aidancurtis/finger_ecg_board/hardware/ecg_board/ecg_board.pdf

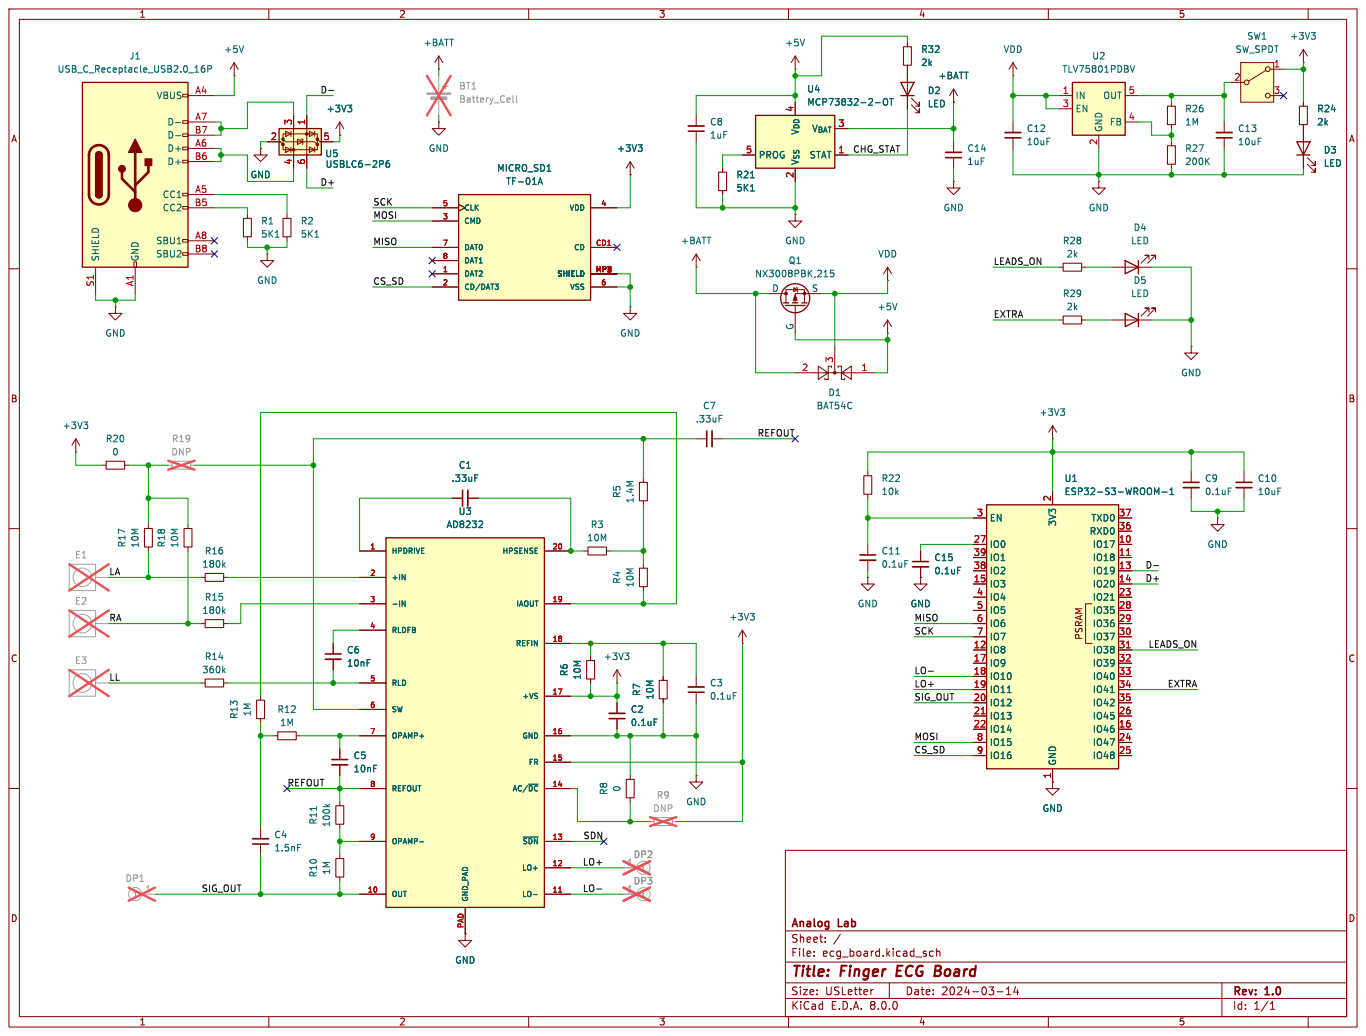
[picture p1: page 1]

2 EN 3 FB 4 OUT 5 U2 TLV75801PDBV R19 DNP

Id: 1/1 Title: Finger ECG Board
