aidancurtis/finger_ecg_board/hardware/ecg_board/ecg_board.kicad_pcb

## KiCad design hardware/ecg_board/ecg_board.kicad_pcb (2024-04-04)

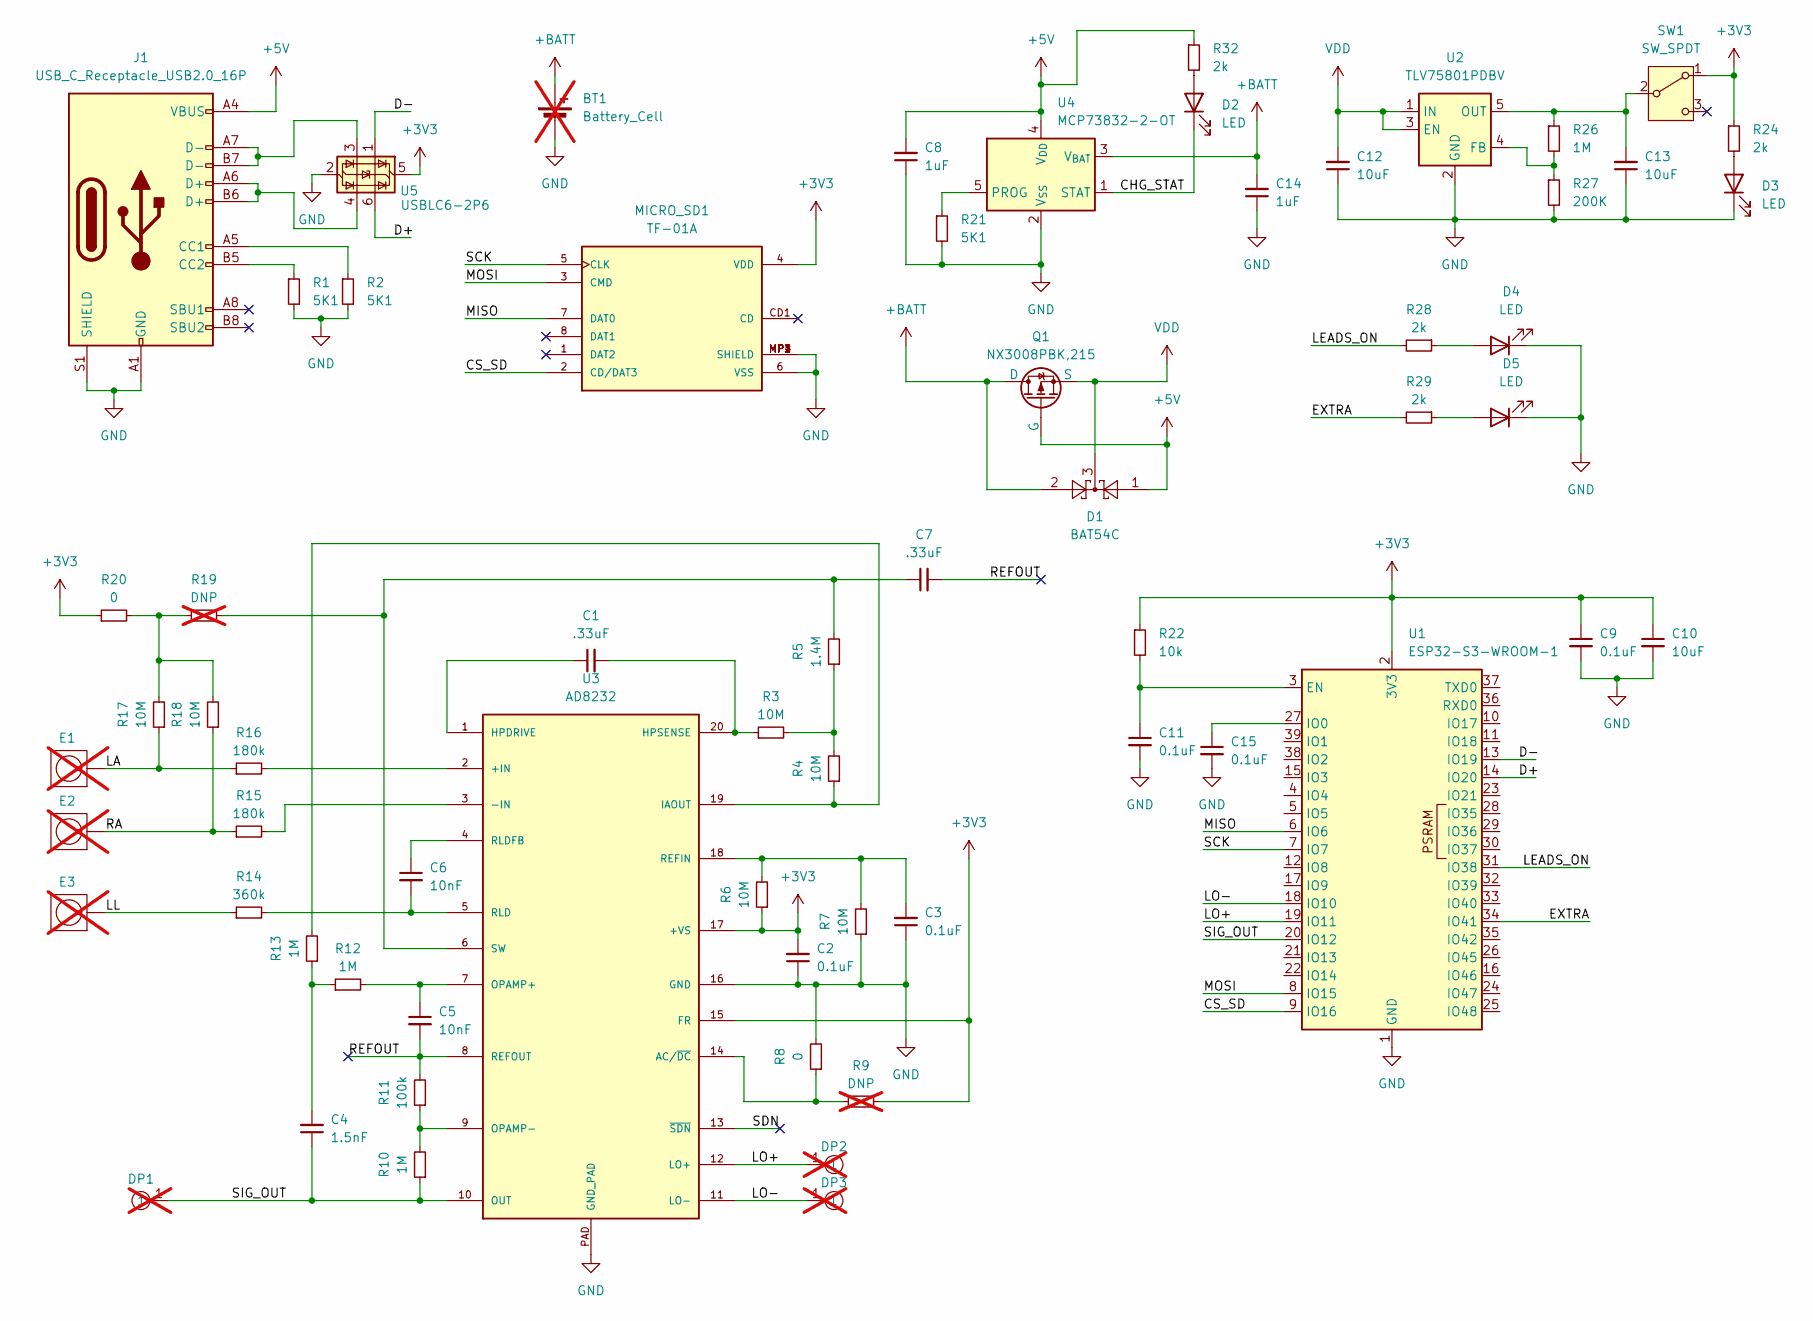
[picture p2: schematic ecg_board.kicad_sch, Finger ECG Board]

Parts:
BT1: Battery_Cell; battery_pads; not fitted
C1, C7: .33uF; C_0603_1608Metric; LCSC Part # C2991452
C2, C3, C9, C11, C15: 0.1uF; C_0603_1608Metric; LCSC Part # C14663
C4: 1.5nF; C_0603_1608Metric; LCSC Part # C1588
C5, C6: 10nF; C_0603_1608Metric; LCSC Part # C57112
C8, C14: 1uF; C_0603_1608Metric; LCSC Part # C15849
C10, C12, C13: 10uF; C_0805_2012Metric; LCSC Part # C19702
D1: BAT54C; SOT-23; LCSC Part # C2828464
D2, D3, D4: LED; LED_0603_1608Metric; LCSC Part # C2286
D5: LED; LED_0603_1608Metric; LCSC Part # C5123548
DP1, DP2, DP3: DebugPad; not fitted
E1, E2, E3: Finger_Electrode; not fitted
J1: USB_C_Receptacle_USB2.0_16P; USB_C_Receptacle_HCTL_HC-TYPE-C-16P-01A; LCSC Part # C2927038
MICRO_SD1: TF-01A; LCSC Part # C2889258
Q1: NX3008PBK,215; SOT-23-3; LCSC Part # C131670
R1, R2, R21: 5K1; R_0603_1608Metric; LCSC Part # C23186
R3, R4, R6, R7, R17, R18: 10M; R_0603_1608Metric; LCSC Part # C7250
R5: 1.4M; R_0603_1608Metric; LCSC Part # C3016282
R8, R20: 0; R_0603_1608Metric; LCSC Part # C21189
R9, R19: DNP; R_0603_1608Metric; not fitted
R10, R12, R13, R26: 1M; R_0603_1608Metric; LCSC Part # C22935
R11: 100k; R_0603_1608Metric; LCSC Part # C25803
R14: 360k; R_0603_1608Metric; LCSC Part # C3016408
R15, R16: 180k; R_0603_1608Metric; LCSC Part # C325602
R22: 10k; R_0603_1608Metric; LCSC Part # C25804
R24, R28, R29, R32: 2k; R_0603_1608Metric; LCSC Part # C22975
R27: 200K; R_0603_1608Metric; LCSC Part # C25811
SW1: SW_SPDT; SW_SPDT_PCM12; LCSC Part # C109335
U1: ESP32-S3-WROOM-1; LCSC Part # C2913197
U2: TLV75801PDBV; SOT-23-5; LCSC Part # C2877852
U3: AD8232; LFCSP_20; LCSC Part # C43216
U4: MCP73832-2-OT; SOT-23-5; LCSC Part # C38066
U5: USBLC6-2P6; SOT-666; LCSC Part # C2827693

Connections:
+3V3: C2.2, C9.1, C10.1, MICRO_SD1.4 (VDD), R6.1, R9.2, R20.1, R22.1, R24.1, SW1.1 (A), U1.2 (3V3), U3.15 (FR), U3.17 (+VS), U5.5 (VBUS)
+5V: C8.2, D1.1, J1.A4 (VBUS), J1.A9 (VBUS), J1.B4 (VBUS), J1.B9 (VBUS), Q1.2 (G), R32.1, U4.4 (V_{DD})
+BATT: BT1.1 (+), C14.2, D1.2, Q1.1 (D), U4.3 (V_{BAT})
/CHG_STAT: D2.1 (K), U4.1 (STAT)
/CS_SD: MICRO_SD1.2 (CD/DAT3), U1.9 (IO16)
/D+: U1.14 (IO20), U5.6 (I/O1)
/D-: U1.13 (IO19), U5.1 (I/O1)
/EXTRA: R29.2, U1.34 (IO41)
/LA: E1.1, R16.1, R17.1
/LEADS_ON: R28.2, U1.31 (IO38)
/LL: E3.1, R14.1
/LO+: DP2.1, U1.19 (IO11), U3.12 (LO+); also elsewhere on the board
/LO-: DP3.1, U1.18 (IO10), U3.11 (LO-); also elsewhere on the board
/MISO: MICRO_SD1.7 (DAT0), U1.6 (IO6)
/MOSI: MICRO_SD1.3 (CMD), U1.8 (IO15)
/RA: E2.1, R15.1, R18.1
/REFOUT: C5.2, C7.2, R11.2, U3.8 (REFOUT)
/SCK: MICRO_SD1.5 (CLK), U1.7 (IO7)
/SDN: U3.13 (~SDN)
/SIG_OUT: C4.1, DP1.1, R10.1, U1.20 (IO12), U3.10 (OUT); also elsewhere on the board
GND: BT1.2 (-), C2.1, C3.1, C8.1, C9.2, C10.2, C11.2, C12.1, C13.1, C14.1, C15.2, D3.1 (K), D4.1 (K), D5.1 (K), J1.A1 (GND), J1.A12 (GND), J1.B1 (GND), J1.B12 (GND), J1.S1 (SHIELD), MICRO_SD1.6 (VSS), MICRO_SD1.MP1 (SHIELD), MICRO_SD1.MP2 (SHIELD), MICRO_SD1.MP3 (SHIELD), MICRO_SD1.MP4 (SHIELD), R1.2, R2.2, R7.1, R8.2, R21.2, R27.2, U1.1 (GND), U1.40 (GND), U1.41 (GND), U2.2 (GND), U3.16 (GND), U3.PAD (GND_PAD), U4.2 (V_{SS}), U5.2 (GND)
unnamed: C4.2, R12.1, R13.1
unnamed: D2.2 (A), R32.2
unnamed: D3.2 (A), R24.2
unnamed: D4.2 (A), R28.1
unnamed: D5.2 (A), R29.1
unnamed: J1.A5 (CC1), R2.1
unnamed: J1.B5 (CC2), R1.1
unnamed: J1.A6 (D+), J1.B6 (D+), U5.4 (I/O2)
unnamed: J1.A7 (D-), J1.B7 (D-), U5.3 (I/O2)
unnamed: R3.2, R4.2, R5.1
unnamed: R17.2, R18.2, R19.1, R20.2
unnamed: C13.2, R26.1, SW1.2 (B), U2.5 (OUT)
unnamed: C11.1, R22.2, U1.3 (EN)
unnamed: C15.1, U1.27 (IO0)
unnamed: R26.2, R27.1, U2.4 (FB)
unnamed: R16.2, U3.2 (+IN)
unnamed: R15.2, U3.3 (-IN)
unnamed: R8.1, R9.1, U3.14 (AC/~DC)
unnamed 39: C1.1, U3.1 (HPDRIVE); also elsewhere on the board
unnamed 40: C1.2, R3.1, U3.20 (HPSENSE); also elsewhere on the board
unnamed: R4.1, R13.2, U3.19 (IAOUT)
unnamed: C5.1, R12.2, U3.7 (OPAMP+)
unnamed: R10.2, R11.1, U3.9 (OPAMP-)
unnamed: C3.2, R6.2, R7.2, U3.18 (REFIN)
unnamed: C6.2, R14.2, U3.5 (RLD)
unnamed: C6.1, U3.4 (RLDFB)
unnamed: C7.1, R5.2, R19.2, U3.6 (SW)
unnamed: R21.1, U4.5 (PROG)
VDD: C12.2, D1.3, Q1.3 (S), U2.1 (IN), U2.3 (EN)

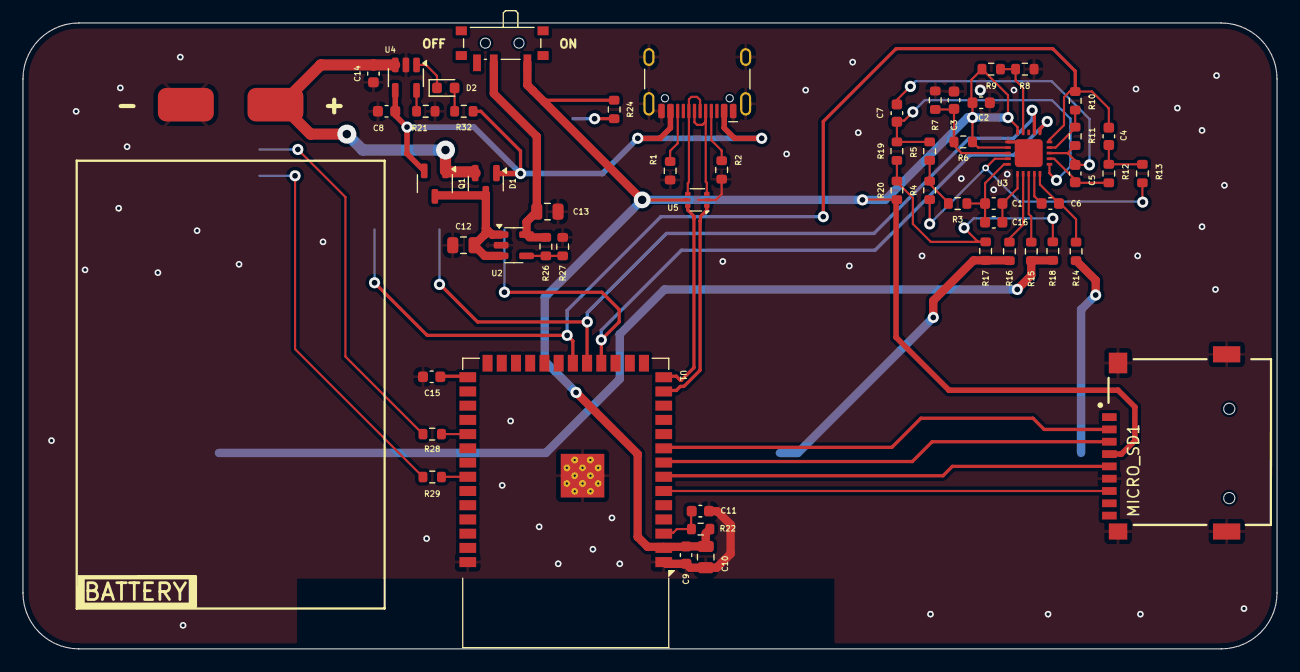
[picture p3: board ecg_board.kicad_pcb from above]

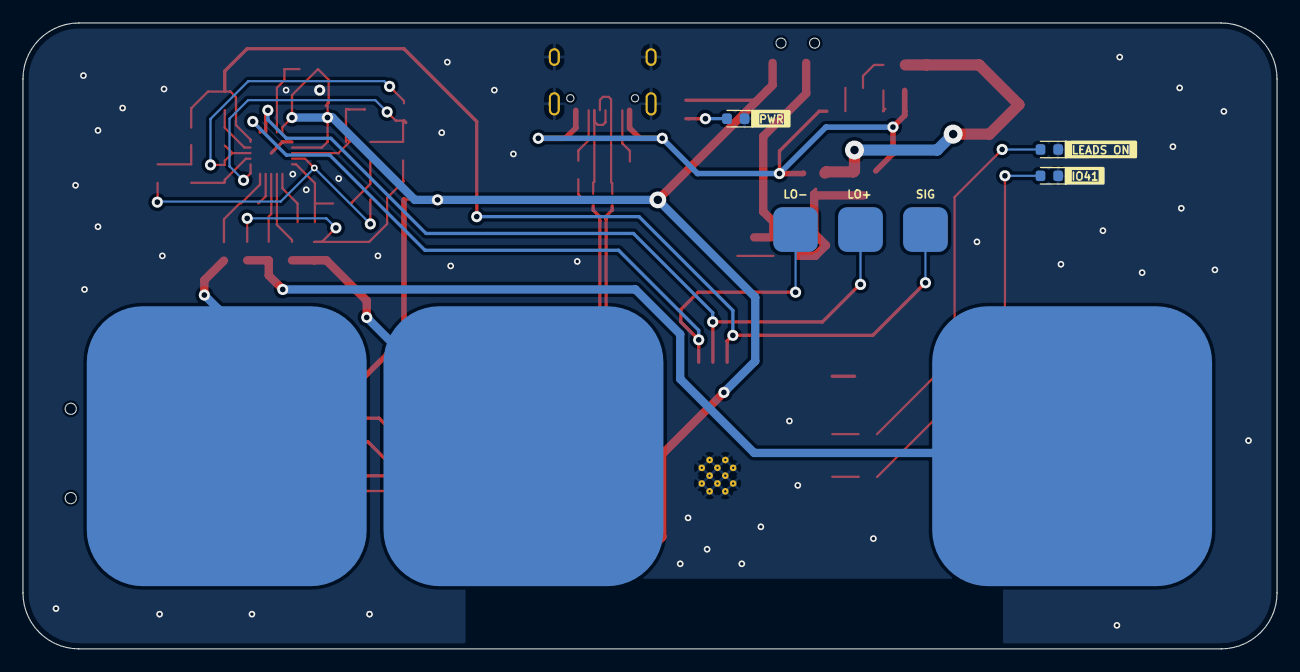
[picture p4: board ecg_board.kicad_pcb from below]

Board: 2 copper layers, 112.0 x 55.9 mm, 65 parts (9 on the bottom side), 49 nets.

Other parts of the board:
C16: 220nF; C_0603_1608Metric
LO+: DebugPad
LO-: DebugPad
SIG: DebugPad

Their connections:
/LO+: LO+.1; also elsewhere on the board
/LO-: LO-.1; also elsewhere on the board
/SIG_OUT: SIG.1; also elsewhere on the board
unnamed 39: C16.1; also elsewhere on the board
unnamed 40: C16.2; also elsewhere on the board
