aidancurtis/finger_ecg_board/(commit log)

2024-03-16 finished schematic v1
    [ecg_board.kicad_pcb, ecg_board.kicad_sch]
2024-03-22 updated schematic and finish pcb v1
    [ecg_board.kicad_pcb, ecg_board.kicad_sch]
2024-03-25 added components and created bom
    [ecg_board-B_Cu.gbl, ecg_board-B_Mask.gbs, ecg_board-B_Paste.gbp, ecg_board-B_Silkscreen.gbo, ecg_board-Edge_Cuts.gm1, ecg_board-F_Cu.gtl, ecg_board-F_Mask.gts, ecg_board-F_Paste.gtp]
2024-03-29 moved switch and fixed bom
    [ecg_board-B_Cu.gbl, ecg_board-B_Mask.gbs, ecg_board-B_Paste.gbp, ecg_board-B_Silkscreen.gbo, ecg_board-Edge_Cuts.gm1, ecg_board-F_Cu.gtl, ecg_board-F_Mask.gts, ecg_board-F_Paste.gtp]
2024-04-04 added debugging pads
    [ecg_board-B_Cu.gbl, ecg_board-B_Mask.gbs, ecg_board-B_Paste.gbp, ecg_board-B_Silkscreen.gbo, ecg_board-Edge_Cuts.gm1, ecg_board-F_Cu.gtl, ecg_board-F_Mask.gts, ecg_board-F_Paste.gtp]
